pythonswirls/Supercluster2/README.md

https://m.youtube.com/watch?v=HRfbQJ6FdF0
