pythonswirls/Supercluster2/ClusterRaymarcher/readme.MD

## BUS

Client perspective:

A1: LED

A2:  CMD 

C0-7: DATA (open drain)

D0: CLK (open drain)

D2..D3: Packet Type (0: reset, 1:RECEIVE, 2:TRANSMIT, 3:BROADCAST) (open drain)

D4: ACK

D5: FULL

D6: EOT
