pythonswirls/Supercluster2/pcb/ClusterProgammer/clusterProgrammer.kicad_pcb

## KiCad design pcb/ClusterProgammer/clusterProgrammer.kicad_pcb (2025-07-05)

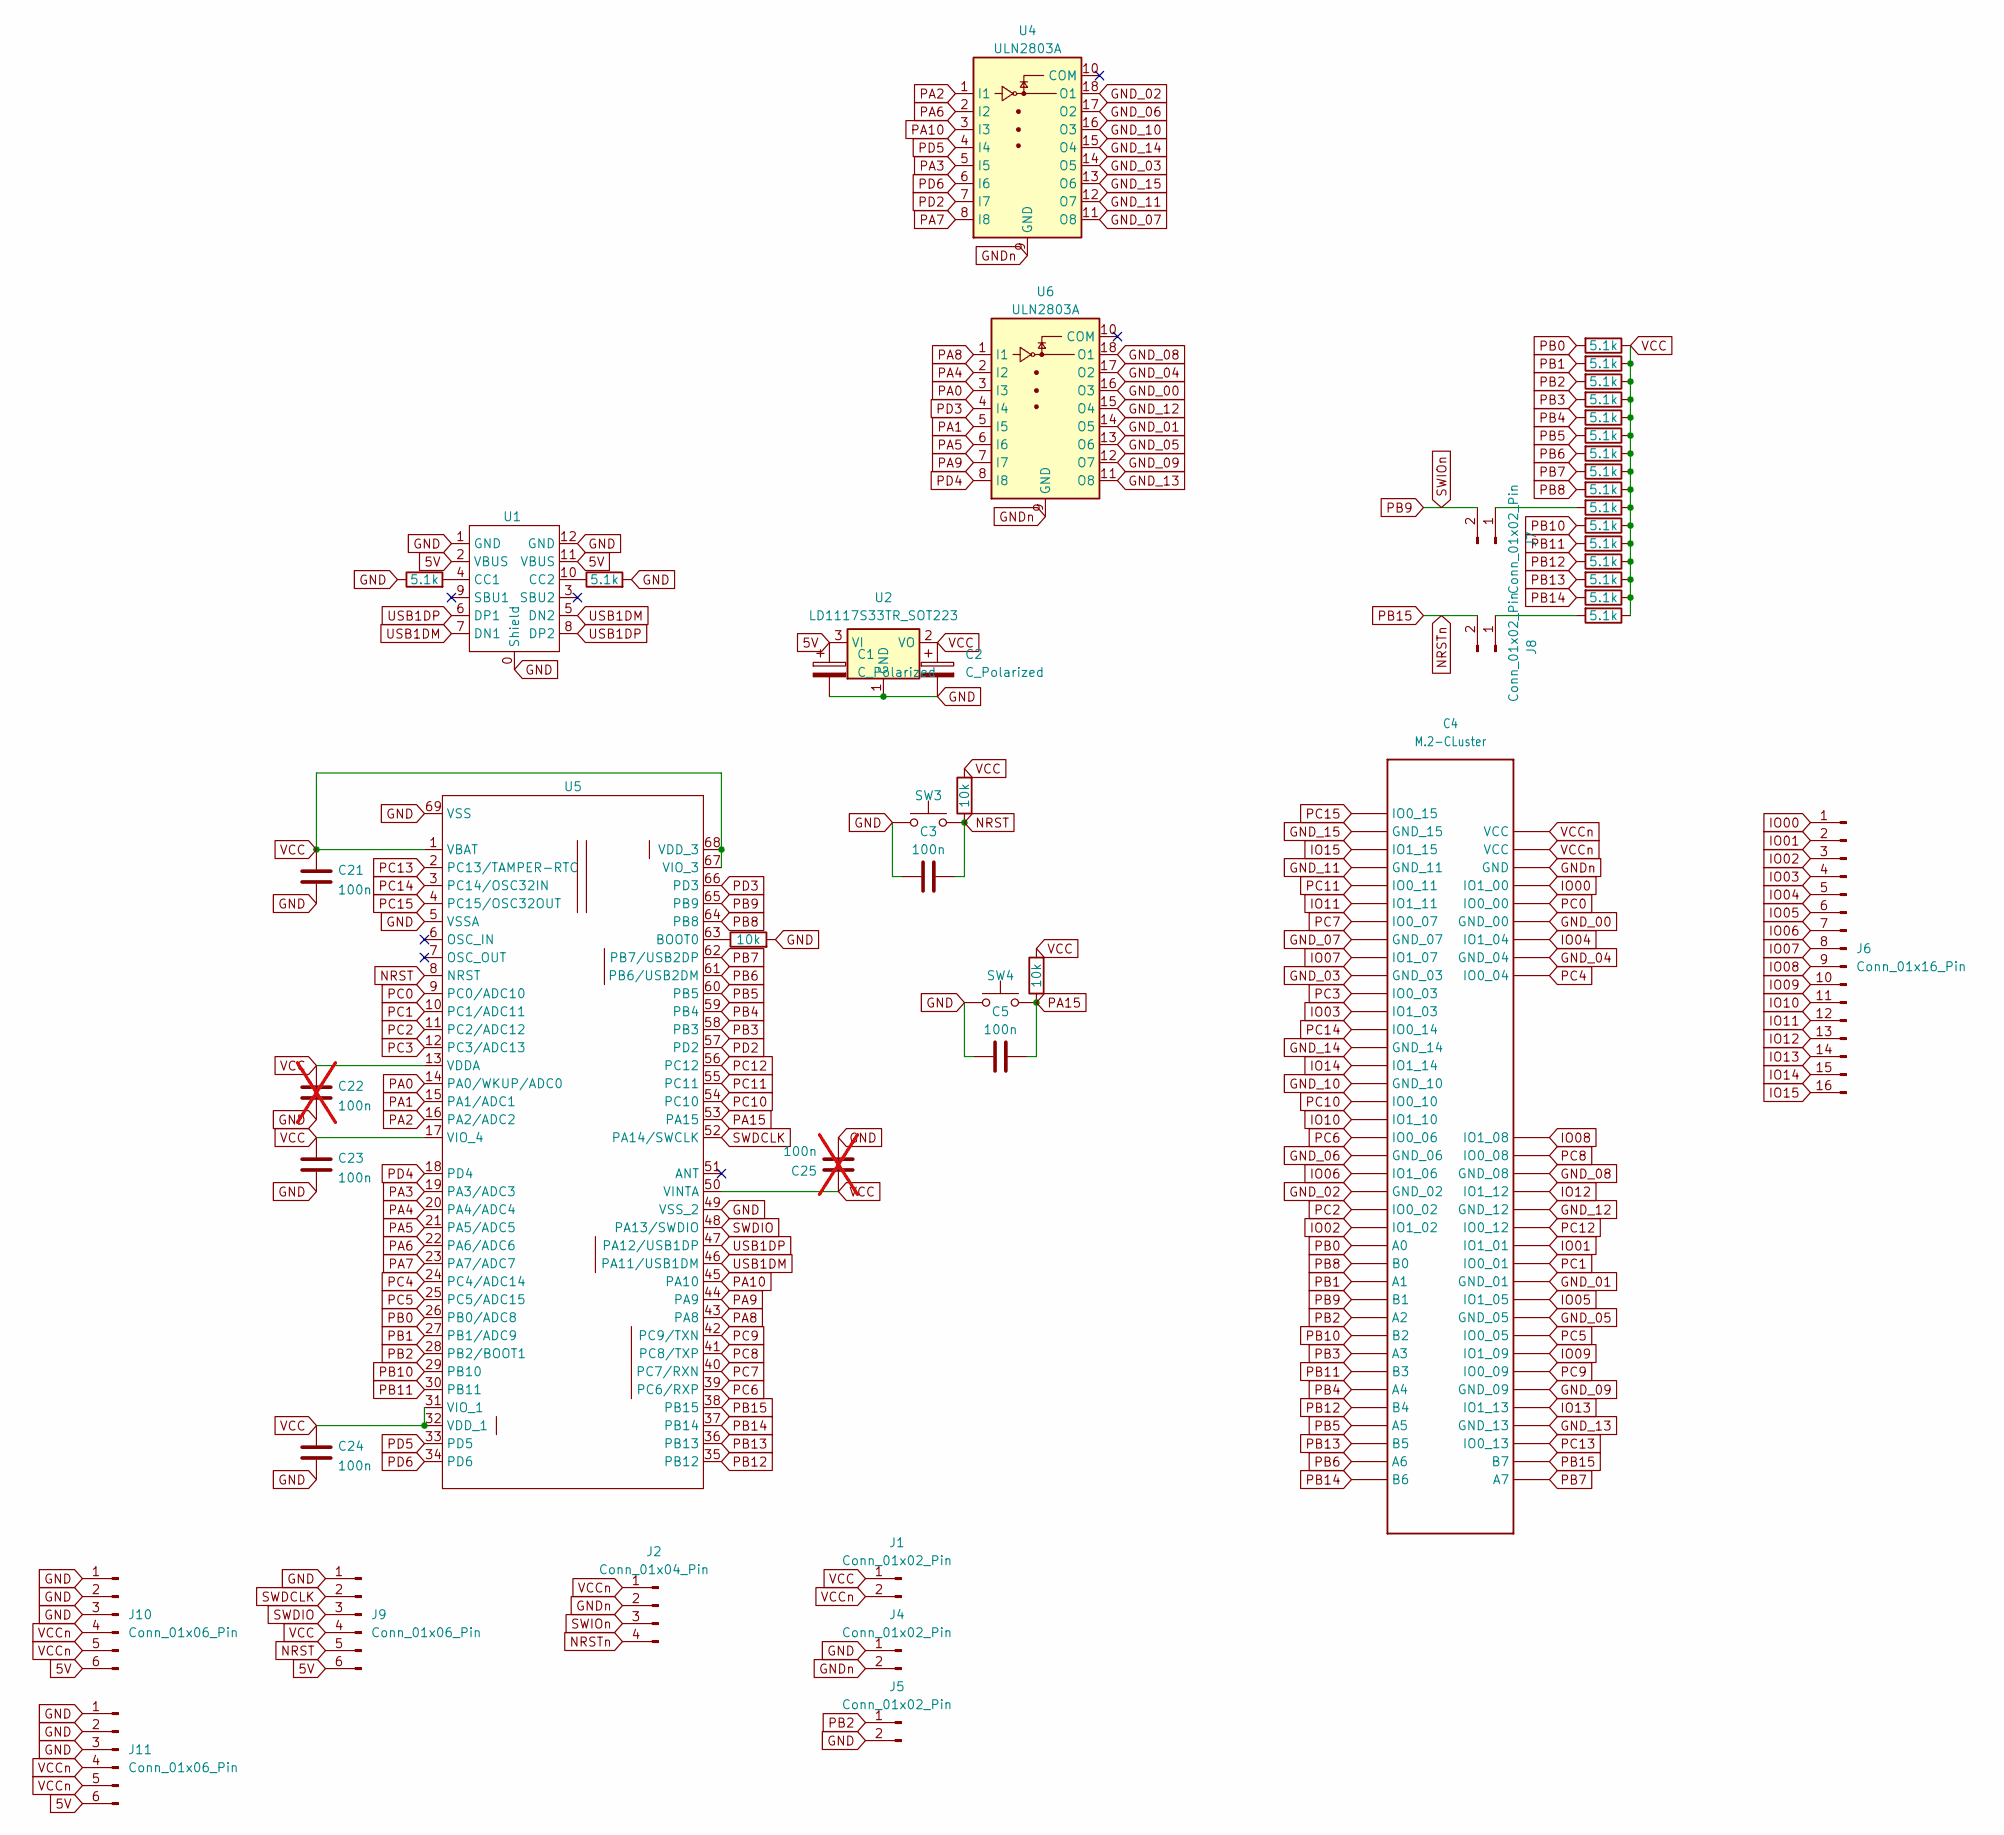
[picture p1: schematic clusterProgrammer.kicad_sch]

Parts:
C1, C2: C_Polarized; CP_Elec_4x4.5
C3, C5, C21, C23, C24: 100n; C_0603_1608Metric
C4: M.2-CLuster; M.2-Vertical
C22, C25: 100n; C_0603_1608Metric; not fitted
J1, J4, J5, J7, J8: Conn_01x02_Pin; PinHeader_1x02_P2.54mm_Vertical
J2: Conn_01x04_Pin; PinHeader_1x04_P2.54mm_Vertical
J6: Conn_01x16_Pin; PinSocket_1x16_P2.54mm_Vertical
J9, J10, J11: Conn_01x06_Pin; PinHeader_1x06_P2.54mm_Vertical
R1, R3, R4, R5, R6, R7, R8, R9, R10, R11, R12, R13, R14, R15, R16, R17, R18, R23: 5.1k; R_0603_1608Metric; LCSC C25905
R20, R21, R22: 10k; R_0603_1608Metric; LCSC C25905
SW3, SW4: miniButton; ButtonSMD5.2x5.2; LCSC C3020033
U1: USB-C; LCSC C165948
U2: LD1117S33TR_SOT223; SOT-223-3_TabPin2
U4, U6: ULN2803A; SOIC-18W_7.5x11.6mm_P1.27mm; LCSC C2828557
U5: QFN-68-1EP_8x8mm_P0.4mm_EP4x4mm; LCSC C5187528

Connections:
5V: C1.1, J9.6, J10.6, J11.6, U1.2 (VBUS), U1.11 (VBUS), U2.3 (VI)
GND: C1.2, C2.2, C3.2, C5.2, C21.2, C22.2, C23.2, C24.2, C25.2, J4.1, J5.2, J9.1, J10.1, J10.2, J10.3, J11.1, J11.2, J11.3, R1.1, R3.2, R20.2, SW3.1, SW4.1, U1.0 (Shield), U1.1 (GND), U1.12 (GND), U2.1 (GND), U5.5 (VSSA), U5.49 (VSS_2), U5.69 (VSS)
GND_00: C4.70 (GND_00), U6.16 (O3)
GND_01: C4.50 (GND_01), U6.14 (O5)
GND_02: C4.22 (GND_02), U4.18 (O1)
GND_03: C4.10 (GND_03), U4.14 (O5)
GND_04: C4.68 (GND_04), U6.17 (O2)
GND_05: C4.48 (GND_05), U6.13 (O6)
GND_06: C4.20 (GND_06), U4.17 (O2)
GND_07: C4.8 (GND_07), U4.11 (O8)
GND_08: C4.56 (GND_08), U6.18 (O1)
GND_09: C4.44 (GND_09), U6.12 (O7)
GND_10: C4.16 (GND_10), U4.16 (O3)
GND_11: C4.4 (GND_11), U4.12 (O7)
GND_12: C4.54 (GND_12), U6.15 (O4)
GND_13: C4.42 (GND_13), U6.11 (O8)
GND_14: C4.14 (GND_14), U4.15 (O4)
GND_15: C4.2 (GND_15), U4.13 (O6)
GNDn: C4.73 (GND), J2.2, J4.2, U4.9 (GND), U6.9 (GND)
IO00: C4.72 (IO1_00), J6.1
IO01: C4.52 (IO1_01), J6.2
IO02: C4.24 (IO1_02), J6.3
IO03: C4.12 (IO1_03), J6.4
IO04: C4.69 (IO1_04), J6.5
IO05: C4.49 (IO1_05), J6.6
IO06: C4.21 (IO1_06), J6.7
IO07: C4.9 (IO1_07), J6.8
IO08: C4.58 (IO1_08), J6.9
IO09: C4.46 (IO1_09), J6.10
IO10: C4.18 (IO1_10), J6.11
IO11: C4.6 (IO1_11), J6.12
IO12: C4.55 (IO1_12), J6.13
IO13: C4.43 (IO1_13), J6.14
IO14: C4.15 (IO1_14), J6.15
IO15: C4.3 (IO1_15), J6.16
NRST: C3.1, J9.5, R21.1, SW3.2, U5.8 (NRST)
NRSTn: C4.40 (B7), J2.4, J8.2, U5.38 (PB15)
unnamed: J7.1, R13.2
unnamed: J8.1, R23.2
unnamed: R1.2, U1.4 (CC1)
unnamed: R3.1, U1.10 (CC2)
unnamed: R20.1, U5.63 (BOOT0)
PA0: U5.14 (PA0/WKUP/ADC0), U6.3 (I3)
PA1: U5.15 (PA1/ADC1), U6.5 (I5)
PA2: U4.1 (I1), U5.16 (PA2/ADC2)
PA3: U4.5 (I5), U5.19 (PA3/ADC3)
PA4: U5.20 (PA4/ADC4), U6.2 (I2)
PA5: U5.21 (PA5/ADC5), U6.6 (I6)
PA6: U4.2 (I2), U5.22 (PA6/ADC6)
PA7: U4.8 (I8), U5.23 (PA7/ADC7)
PA8: U5.43 (PA8), U6.1 (I1)
PA9: U5.44 (PA9), U6.7 (I7)
PA10: U4.3 (I3), U5.45 (PA10)
PA15: C5.1, R22.1, SW4.2, U5.53 (PA15)
PB0: C4.25 (A0), R7.2, U5.26 (PB0/ADC8)
PB1: C4.27 (A1), R6.2, U5.27 (PB1/ADC9)
PB2: C4.29 (A2), J5.1, R5.2, U5.28 (PB2/BOOT1)
PB3: C4.31 (A3), R4.2, U5.58 (PB3)
PB4: C4.33 (A4), R8.2, U5.59 (PB4)
PB5: C4.35 (A5), R9.2, U5.60 (PB5)
PB6: C4.37 (A6), R10.2, U5.61 (PB6/USB2DM)
PB7: C4.39 (A7), R11.2, U5.62 (PB7/USB2DP)
PB8: C4.26 (B0), R12.2, U5.64 (PB8)
PB9: C4.28 (B1), J2.3, J7.2, U5.65 (PB9)
PB10: C4.30 (B2), R14.2, U5.29 (PB10)
PB11: C4.32 (B3), R15.2, U5.30 (PB11)
PB12: C4.34 (B4), R16.2, U5.35 (PB12)
PB13: C4.36 (B5), R17.2, U5.36 (PB13)
PB14: C4.38 (B6), R18.2, U5.37 (PB14)
PC0: C4.71 (IO0_00), U5.9 (PC0/ADC10)
PC1: C4.51 (IO0_01), U5.10 (PC1/ADC11)
PC2: C4.23 (IO0_02), U5.11 (PC2/ADC12)
PC3: C4.11 (IO0_03), U5.12 (PC3/ADC13)
PC4: C4.67 (IO0_04), U5.24 (PC4/ADC14)
PC5: C4.47 (IO0_05), U5.25 (PC5/ADC15)
PC6: C4.19 (IO0_06), U5.39 (PC6/RXP)
PC7: C4.7 (IO0_07), U5.40 (PC7/RXN)
PC8: C4.57 (IO0_08), U5.41 (PC8/TXP)
PC9: C4.45 (IO0_09), U5.42 (PC9/TXN)
PC10: C4.17 (IO0_10), U5.54 (PC10)
PC11: C4.5 (IO0_11), U5.55 (PC11)
PC12: C4.53 (IO0_12), U5.56 (PC12)
PC13: C4.41 (IO0_13), U5.2 (PC13/TAMPER-RTC)
PC14: C4.13 (IO0_14), U5.3 (PC14/OSC32IN)
PC15: C4.1 (IO0_15), U5.4 (PC15/OSC32OUT)
PD2: U4.7 (I7), U5.57 (PD2)
PD3: U5.66 (PD3), U6.4 (I4)
PD4: U5.18 (PD4), U6.8 (I8)
PD5: U4.4 (I4), U5.33 (PD5)
PD6: U4.6 (I6), U5.34 (PD6)
SWDCLK: J9.2, U5.52 (PA14/SWCLK)
SWDIO: J9.3, U5.48 (PA13/SWDIO)
USB1DM: U1.5 (DN2), U1.7 (DN1), U5.46 (PA11/USB1DM)
USB1DP: U1.6 (DP1), U1.8 (DP2), U5.47 (PA12/USB1DP)
VCC: C2.1, C21.1, C22.1, C23.1, C24.1, C25.1, J1.1, J9.4, R4.1, R5.1, R6.1, R7.1, R8.1, R9.1, R10.1, R11.1, R12.1, R13.1, R14.1, R15.1, R16.1, R17.1, R18.1, R21.2, R22.2, R23.1, U2.2 (VO), U5.1 (VBAT), U5.13 (VDDA), U5.17 (VIO_4), U5.31 (VIO_1), U5.32 (VDD_1), U5.50 (VINTA), U5.67 (VIO_3), U5.68 (VDD_3)
VCCn: C4.74 (VCC), C4.75 (VCC), J1.2, J2.1, J10.4, J10.5, J11.4, J11.5

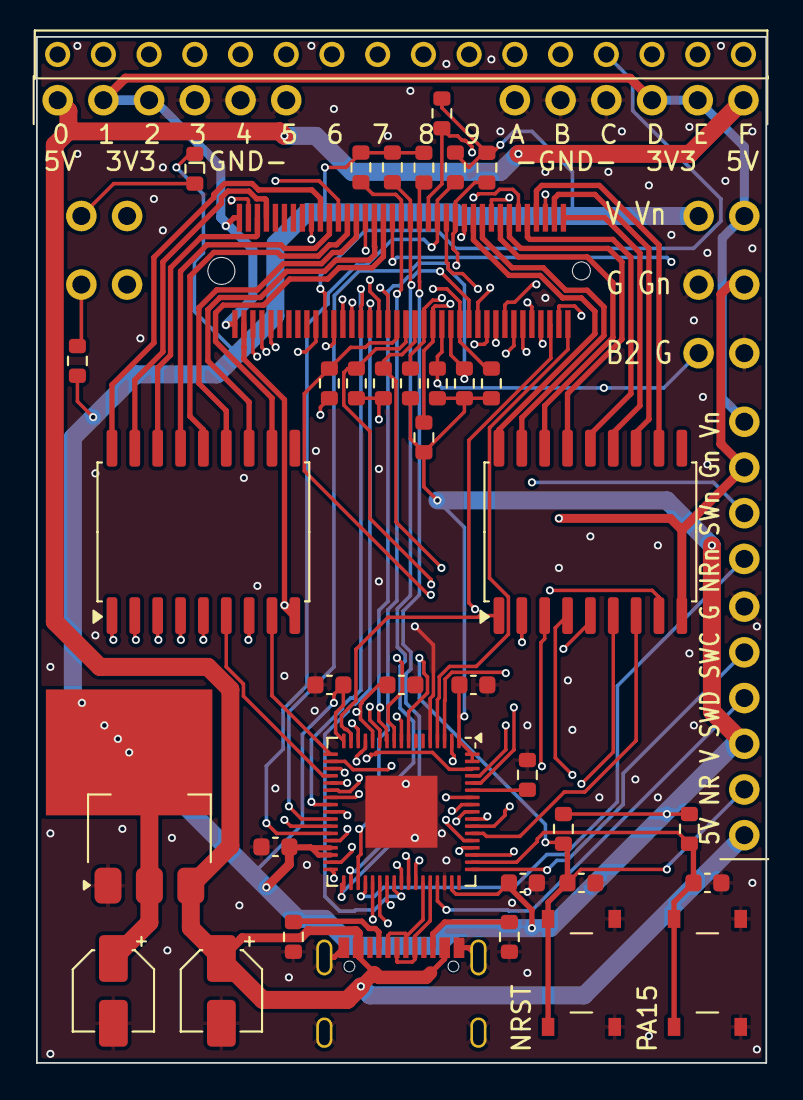
[picture p2: board clusterProgrammer.kicad_pcb from above]

Board: 4 copper layers, 40.5 x 57.0 mm, 48 parts (0 on the bottom side), 96 nets.
