pythonswirls/Supercluster2/pcb/ClusterBase/clusterbase.kicad_pcb

## KiCad design pcb/ClusterBase/clusterbase.kicad_pcb (2025-07-05)

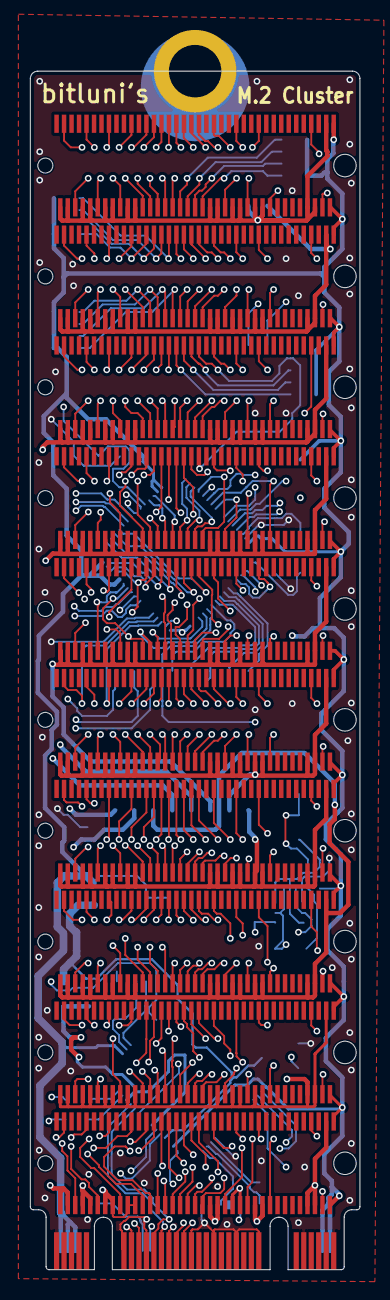
[picture p3: board clusterbase.kicad_pcb from above]

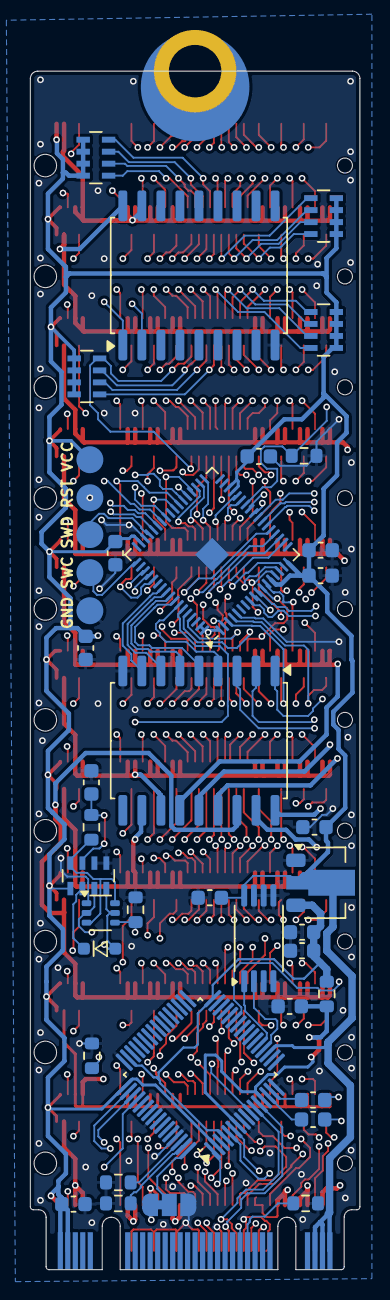
[picture p4: board clusterbase.kicad_pcb from below]

Board: 4 copper layers, 22.0 x 80.0 mm, 48 parts (37 on the bottom side), 82 nets.

Parts:
C1, C2, C3, C10, C12, C15, C26, C27, C28, C29, C30, C31: 100n; C_0603_1608Metric
C5, C6, C7, C9, C13, C14, C18, C19, C20, C21: M.2-CLuster; M.2-Vertical-short Pads
C8, C11: 10u; C_0603_1608Metric
D1: D; D_SOD-323
JP2: Jumper_3_Bridged12; SolderJumper-3_P1.3mm_Bridged12_RoundedPad1.0x1.5mm
Q1: UMH3N; SOT-363_SC-70-6
R9, R10, R11: 0; R_0603_1608Metric
R12: 12k; R_0603_1608Metric
R15, R16: 100k; R_0603_1608Metric
R18, R19: 10k; R_0603_1608Metric
RN6, RN7, RN8, RN9: 1k; R_Array_Concave_4x0603
RN10: 10k; R_Array_Concave_4x0603
TP2: TestPoint; Testpoint5
U1: CH382; LQFP-64_7x7mm_P0.4mm
U2: M.2-B+M-KEY-PCIe; M.2-B+M-KEY 2280
U3: MCP1703Ax-180xxMB; SOT-89-3
U4: M24C02-FDW; TSSOP-8_4.4x3mm_P0.65mm
U5, U7: ULN2803A; SOIC-18W_7.5x11.6mm_P1.27mm
U6: QFN-68-1EP_8x8mm_P0.4mm_EP1x1mm

Connections:
1V8: C10.2, C11.2, R9.1, U1.4 (VCC18), U1.32 (VCC18), U1.47 (VCC18), U3.3 (VO)
1V8A: C12.2, R9.2, U1.7 (VCC18A), U1.13 (VCC18A)
/CKSEL: JP2.2 (C), U1.64 (CKSEL)
/CLKREQ#: R18.2, U2.P$52 (CLKREQ#)
/DTR: Q1.2 (B1), RN10.3 (R3.1), U1.52 (DTR0)
/PECK+: U1.5 (PECK+), U2.P$55 (REFCLK+)
/PECK-: U1.6 (PECK-), U2.P$53 (REFCLK-)
/PER+: U1.11 (PER+), U2.P$49 (PER0+)
/PER-: U1.12 (PER-), U2.P$47 (PER0-)
/PET+: C2.2, U1.15 (PET+)
/PET-: C1.2, U1.14 (PET-)
/RST#: JP2.1 (A), U1.1 (PERST#), U2.P$50 (PERST#)
/RST_CH32#: C26.1, R16.2, RN10.7 (R2.2), TP2.4, U6.8 (NRST)
/RTS: D1.2 (A), Q1.5 (B2), RN10.4 (R4.1), U1.51 (RTS0)
/RX: U1.27 (RXD0), U6.44 (PA9)
/TX: U1.50 (TXD0), U6.45 (PA10)
BOOT0: Q1.4 (E2), R15.1, U6.63 (BOOT0)
GND: C3.1, C8.1, C10.1, C11.1, C12.1, C15.1, C26.2, C27.2, C28.2, C29.2, C30.2, C31.2, JP2.3 (B), Q1.1 (E1), R10.2, R11.2, R12.2, R15.2, R18.1, R19.2, RN10.5 (R4.2), RN10.6 (R3.2), TP2.1, U1.3 (GND), U1.8 (GND), U1.9 (GND), U1.16 (GND), U1.33 (GND), U1.48 (GND), U1.56 (GND), U1.61 (GND), U2.P$1 (CONFIG3/GND), U2.P$3 (GND), U2.P$9 (GND), U2.P$21 (CONFIG_0/GND), U2.P$27 (GND), U2.P$33 (GND), U2.P$39 (GND), U2.P$45 (GND), U2.P$51 (GND), U2.P$57 (GND), U2.P$71 (GND), U2.P$73 (GND), U2.P$75 (CONFIG_2/GND), U3.1 (GND), U4.3 (E2), U4.4 (VSS), U4.5 (SDA), U4.6 (SCL), U4.7 (~WC), U5.9 (GND), U6.5 (VSSA), U6.49 (VSS_2), U6.69 (VSS), U7.9 (GND)
GND00: C5.2 (GND_15), C5.4 (GND_11), C5.8 (GND_07), C5.10 (GND_03), C5.14 (GND_14), C5.16 (GND_10), C5.20 (GND_06), C5.22 (GND_02), C5.42 (GND_13), C5.44 (GND_09), C5.48 (GND_05), C5.50 (GND_01), C5.54 (GND_12), C5.56 (GND_08), C5.68 (GND_04), C5.70 (GND_00), C5.73 (GND), U5.17 (O2)
GND01: C6.2 (GND_15), C6.4 (GND_11), C6.8 (GND_07), C6.10 (GND_03), C6.14 (GND_14), C6.16 (GND_10), C6.20 (GND_06), C6.22 (GND_02), C6.42 (GND_13), C6.44 (GND_09), C6.48 (GND_05), C6.50 (GND_01), C6.54 (GND_12), C6.56 (GND_08), C6.68 (GND_04), C6.70 (GND_00), C6.73 (GND), U5.18 (O1)
GND02: C7.2 (GND_15), C7.4 (GND_11), C7.8 (GND_07), C7.10 (GND_03), C7.14 (GND_14), C7.16 (GND_10), C7.20 (GND_06), C7.22 (GND_02), C7.42 (GND_13), C7.44 (GND_09), C7.48 (GND_05), C7.50 (GND_01), C7.54 (GND_12), C7.56 (GND_08), C7.68 (GND_04), C7.70 (GND_00), C7.73 (GND), U5.16 (O3)
GND03: C9.2 (GND_15), C9.4 (GND_11), C9.8 (GND_07), C9.10 (GND_03), C9.14 (GND_14), C9.16 (GND_10), C9.20 (GND_06), C9.22 (GND_02), C9.42 (GND_13), C9.44 (GND_09), C9.48 (GND_05), C9.50 (GND_01), C9.54 (GND_12), C9.56 (GND_08), C9.68 (GND_04), C9.70 (GND_00), C9.73 (GND), U5.11 (O8)
GND04: C13.2 (GND_15), C13.4 (GND_11), C13.8 (GND_07), C13.10 (GND_03), C13.14 (GND_14), C13.16 (GND_10), C13.20 (GND_06), C13.22 (GND_02), C13.42 (GND_13), C13.44 (GND_09), C13.48 (GND_05), C13.50 (GND_01), C13.54 (GND_12), C13.56 (GND_08), C13.68 (GND_04), C13.70 (GND_00), C13.73 (GND), U5.12 (O7)
GND05: C14.2 (GND_15), C14.4 (GND_11), C14.8 (GND_07), C14.10 (GND_03), C14.14 (GND_14), C14.16 (GND_10), C14.20 (GND_06), C14.22 (GND_02), C14.42 (GND_13), C14.44 (GND_09), C14.48 (GND_05), C14.50 (GND_01), C14.54 (GND_12), C14.56 (GND_08), C14.68 (GND_04), C14.70 (GND_00), C14.73 (GND), U5.13 (O6)
GND06: C18.2 (GND_15), C18.4 (GND_11), C18.8 (GND_07), C18.10 (GND_03), C18.14 (GND_14), C18.16 (GND_10), C18.20 (GND_06), C18.22 (GND_02), C18.42 (GND_13), C18.44 (GND_09), C18.48 (GND_05), C18.50 (GND_01), C18.54 (GND_12), C18.56 (GND_08), C18.68 (GND_04), C18.70 (GND_00), C18.73 (GND), U5.14 (O5)
GND07: C19.2 (GND_15), C19.4 (GND_11), C19.8 (GND_07), C19.10 (GND_03), C19.14 (GND_14), C19.16 (GND_10), C19.20 (GND_06), C19.22 (GND_02), C19.42 (GND_13), C19.44 (GND_09), C19.48 (GND_05), C19.50 (GND_01), C19.54 (GND_12), C19.56 (GND_08), C19.68 (GND_04), C19.70 (GND_00), C19.73 (GND), U5.15 (O4)
GND08: C20.2 (GND_15), C20.4 (GND_11), C20.8 (GND_07), C20.10 (GND_03), C20.14 (GND_14), C20.16 (GND_10), C20.20 (GND_06), C20.22 (GND_02), C20.42 (GND_13), C20.44 (GND_09), C20.48 (GND_05), C20.50 (GND_01), C20.54 (GND_12), C20.56 (GND_08), C20.68 (GND_04), C20.70 (GND_00), C20.73 (GND), U7.18 (O1)
GND09: C21.2 (GND_15), C21.4 (GND_11), C21.8 (GND_07), C21.10 (GND_03), C21.14 (GND_14), C21.16 (GND_10), C21.20 (GND_06), C21.22 (GND_02), C21.42 (GND_13), C21.44 (GND_09), C21.48 (GND_05), C21.50 (GND_01), C21.54 (GND_12), C21.56 (GND_08), C21.68 (GND_04), C21.70 (GND_00), C21.73 (GND), U7.17 (O2)
unnamed: D1.1 (K), RN10.2 (R2.1)
unnamed: Q1.3 (C2), Q1.6 (C1), R16.1, RN10.8 (R1.2)
unnamed: R11.1, U1.62 (MDPRT#)
unnamed: R10.1, U1.63 (MDSEL)
unnamed: R12.1, U1.10 (RREF)
unnamed: U1.20 (SCL), U4.2 (E1)
unnamed: U1.21 (SDA), U4.1 (E0)
unnamed: C2.1, U2.P$43 (PET0+)
unnamed: C1.1, U2.P$41 (PET0-)
PA0: C5.25 (A0), C6.25 (A0), C7.25 (A0), C9.25 (A0), C13.25 (A0), C14.25 (A0), C18.25 (A0), C19.25 (A0), C20.25 (A0), C21.25 (A0), RN6.4 (R4.1), U6.14 (PA0/WKUP/ADC0)
PA1: C5.27 (A1), C6.27 (A1), C7.27 (A1), C9.27 (A1), C13.27 (A1), C14.27 (A1), C18.27 (A1), C19.27 (A1), C20.27 (A1), C21.27 (A1), RN6.3 (R3.1), U6.15 (PA1/ADC1)
PA2: C5.29 (A2), C6.29 (A2), C7.29 (A2), C9.29 (A2), C13.29 (A2), C14.29 (A2), C18.29 (A2), C19.29 (A2), C20.29 (A2), C21.29 (A2), RN6.2 (R2.1), U6.16 (PA2/ADC2)
PA3: C5.31 (A3), C6.31 (A3), C7.31 (A3), C9.31 (A3), C13.31 (A3), C14.31 (A3), C18.31 (A3), C19.31 (A3), C20.31 (A3), C21.31 (A3), RN6.1 (R1.1), U6.19 (PA3/ADC3)
PA4: C5.33 (A4), C6.33 (A4), C7.33 (A4), C9.33 (A4), C13.33 (A4), C14.33 (A4), C18.33 (A4), C19.33 (A4), C20.33 (A4), C21.33 (A4), RN7.1 (R1.1), U6.20 (PA4/ADC4)
PA5: C5.35 (A5), C6.35 (A5), C7.35 (A5), C9.35 (A5), C13.35 (A5), C14.35 (A5), C18.35 (A5), C19.35 (A5), C20.35 (A5), C21.35 (A5), RN7.2 (R2.1), U6.21 (PA5/ADC5)
PA6: C5.37 (A6), C6.37 (A6), C7.37 (A6), C9.37 (A6), C13.37 (A6), C14.37 (A6), C18.37 (A6), C19.37 (A6), C20.37 (A6), C21.37 (A6), RN7.3 (R3.1), U6.22 (PA6/ADC6)
PA7: C5.39 (A7), C6.39 (A7), C7.39 (A7), C9.39 (A7), C13.39 (A7), C14.39 (A7), C18.39 (A7), C19.39 (A7), C20.39 (A7), C21.39 (A7), RN7.4 (R4.1), U6.23 (PA7/ADC7)
PA11: U6.46 (PA11/USB1DM), U7.1 (I1)
PA12: U6.47 (PA12/USB1DP), U7.2 (I2)
PA13: TP2.3, U6.48 (PA13/SWDIO)
PA14: TP2.2, U6.52 (PA14/SWCLK)
PB0: U5.2 (I2), U6.26 (PB0/ADC8)
PB1: U5.1 (I1), U6.27 (PB1/ADC9)
PB2: R19.1, U5.3 (I3), U6.28 (PB2/BOOT1)
PB3: U5.8 (I8), U6.58 (PB3)
PB4: U5.7 (I7), U6.59 (PB4)
PB5: U5.6 (I6), U6.60 (PB5)
PB6: U5.5 (I5), U6.61 (PB6/USB2DM)
PB7: U5.4 (I4), U6.62 (PB7/USB2DP)
PB8: C5.26 (B0), C6.26 (B0), C7.26 (B0), C9.26 (B0), C13.26 (B0), C14.26 (B0), C18.26 (B0), C19.26 (B0), C20.26 (B0), C21.26 (B0), RN8.1 (R1.1), U6.64 (PB8)
PB9: C5.28 (B1), C6.28 (B1), C7.28 (B1), C9.28 (B1), C13.28 (B1), C14.28 (B1), C18.28 (B1), C19.28 (B1), C20.28 (B1), C21.28 (B1), RN8.2 (R2.1), U6.65 (PB9)
PB10: C5.30 (B2), C6.30 (B2), C7.30 (B2), C9.30 (B2), C13.30 (B2), C14.30 (B2), C18.30 (B2), C19.30 (B2), C20.30 (B2), C21.30 (B2), RN8.3 (R3.1), U6.29 (PB10)
PB11: C5.32 (B3), C6.32 (B3), C7.32 (B3), C9.32 (B3), C13.32 (B3), C14.32 (B3), C18.32 (B3), C19.32 (B3), C20.32 (B3), C21.32 (B3), RN8.4 (R4.1), U6.30 (PB11)
PB12: C5.34 (B4), C6.34 (B4), C7.34 (B4), C9.34 (B4), C13.34 (B4), C14.34 (B4), C18.34 (B4), C19.34 (B4), C20.34 (B4), C21.34 (B4), RN9.4 (R4.1), U6.35 (PB12)
PB13: C5.36 (B5), C6.36 (B5), C7.36 (B5), C9.36 (B5), C13.36 (B5), C14.36 (B5), C18.36 (B5), C19.36 (B5), C20.36 (B5), C21.36 (B5), RN9.3 (R3.1), U6.36 (PB13)
PB14: C5.38 (B6), C6.38 (B6), C7.38 (B6), C9.38 (B6), C13.38 (B6), C14.38 (B6), C18.38 (B6), C19.38 (B6), C20.38 (B6), C21.38 (B6), RN9.2 (R2.1), U6.37 (PB14)
PB15: C5.40 (B7), C6.40 (B7), C7.40 (B7), C9.40 (B7), C13.40 (B7), C14.40 (B7), C18.40 (B7), C19.40 (B7), C20.40 (B7), C21.40 (B7), RN9.1 (R1.1), U6.38 (PB15)
PC0: C5.72 (IO1_00), C6.72 (IO1_00), C7.72 (IO1_00), C9.72 (IO1_00), C13.72 (IO1_00), C14.72 (IO1_00), C18.72 (IO1_00), C19.72 (IO1_00), C20.72 (IO1_00), C21.72 (IO1_00), U6.9 (PC0/ADC10)
PC1: C5.52 (IO1_01), C6.52 (IO1_01), C7.52 (IO1_01), C9.52 (IO1_01), C13.52 (IO1_01), C14.52 (IO1_01), C18.52 (IO1_01), C19.52 (IO1_01), C20.52 (IO1_01), C21.52 (IO1_01), U6.10 (PC1/ADC11)
PC2: C5.24 (IO1_02), C6.24 (IO1_02), C7.24 (IO1_02), C9.24 (IO1_02), C13.24 (IO1_02), C14.24 (IO1_02), C18.24 (IO1_02), C19.24 (IO1_02), C20.24 (IO1_02), C21.24 (IO1_02), U6.11 (PC2/ADC12)
PC3: C5.12 (IO1_03), C6.12 (IO1_03), C7.12 (IO1_03), C9.12 (IO1_03), C13.12 (IO1_03), C14.12 (IO1_03), C18.12 (IO1_03), C19.12 (IO1_03), C20.12 (IO1_03), C21.12 (IO1_03), U6.12 (PC3/ADC13)
PC4: C5.69 (IO1_04), C6.69 (IO1_04), C7.69 (IO1_04), C9.69 (IO1_04), C13.69 (IO1_04), C14.69 (IO1_04), C18.69 (IO1_04), C19.69 (IO1_04), C20.69 (IO1_04), C21.69 (IO1_04), U6.24 (PC4/ADC14)
PC5: C5.49 (IO1_05), C6.49 (IO1_05), C7.49 (IO1_05), C9.49 (IO1_05), C13.49 (IO1_05), C14.49 (IO1_05), C18.49 (IO1_05), C19.49 (IO1_05), C20.49 (IO1_05), C21.49 (IO1_05), U6.25 (PC5/ADC15)
PC6: C5.21 (IO1_06), C6.21 (IO1_06), C7.21 (IO1_06), C9.21 (IO1_06), C13.21 (IO1_06), C14.21 (IO1_06), C18.21 (IO1_06), C19.21 (IO1_06), C20.21 (IO1_06), C21.21 (IO1_06), U6.39 (PC6/RXP)
PC7: C5.9 (IO1_07), C6.9 (IO1_07), C7.9 (IO1_07), C9.9 (IO1_07), C13.9 (IO1_07), C14.9 (IO1_07), C18.9 (IO1_07), C19.9 (IO1_07), C20.9 (IO1_07), C21.9 (IO1_07), U6.40 (PC7/RXN)
PC8: C5.58 (IO1_08), C6.58 (IO1_08), C7.58 (IO1_08), C9.58 (IO1_08), C13.58 (IO1_08), C14.58 (IO1_08), C18.58 (IO1_08), C19.58 (IO1_08), C20.58 (IO1_08), C21.58 (IO1_08), U6.41 (PC8/TXP)
PC9: C5.46 (IO1_09), C6.46 (IO1_09), C7.46 (IO1_09), C9.46 (IO1_09), C13.46 (IO1_09), C14.46 (IO1_09), C18.46 (IO1_09), C19.46 (IO1_09), C20.46 (IO1_09), C21.46 (IO1_09), U6.42 (PC9/TXN)
PC10: C5.18 (IO1_10), C6.18 (IO1_10), C7.18 (IO1_10), C9.18 (IO1_10), C13.18 (IO1_10), C14.18 (IO1_10), C18.18 (IO1_10), C19.18 (IO1_10), C20.18 (IO1_10), C21.18 (IO1_10), U6.54 (PC10)
PC11: C5.6 (IO1_11), C6.6 (IO1_11), C7.6 (IO1_11), C9.6 (IO1_11), C13.6 (IO1_11), C14.6 (IO1_11), C18.6 (IO1_11), C19.6 (IO1_11), C20.6 (IO1_11), C21.6 (IO1_11), U6.55 (PC11)
PC12: C5.55 (IO1_12), C6.55 (IO1_12), C7.55 (IO1_12), C9.55 (IO1_12), C13.55 (IO1_12), C14.55 (IO1_12), C18.55 (IO1_12), C19.55 (IO1_12), C20.55 (IO1_12), C21.55 (IO1_12), U6.56 (PC12)
PC13: C5.43 (IO1_13), C6.43 (IO1_13), C7.43 (IO1_13), C9.43 (IO1_13), C13.43 (IO1_13), C14.43 (IO1_13), C18.43 (IO1_13), C19.43 (IO1_13), C20.43 (IO1_13), C21.43 (IO1_13), U6.2 (PC13/TAMPER-RTC)
PC14: C5.15 (IO1_14), C6.15 (IO1_14), C7.15 (IO1_14), C9.15 (IO1_14), C13.15 (IO1_14), C14.15 (IO1_14), C18.15 (IO1_14), C19.15 (IO1_14), C20.15 (IO1_14), C21.15 (IO1_14), U6.3 (PC14/OSC32IN)
PC15: C5.3 (IO1_15), C6.3 (IO1_15), C7.3 (IO1_15), C9.3 (IO1_15), C13.3 (IO1_15), C14.3 (IO1_15), C18.3 (IO1_15), C19.3 (IO1_15), C20.3 (IO1_15), C21.3 (IO1_15), U6.4 (PC15/OSC32OUT)
VCC: C3.2, C5.74 (VCC), C5.75 (VCC), C6.74 (VCC), C6.75 (VCC), C7.74 (VCC), C7.75 (VCC), C8.2, C9.74 (VCC), C9.75 (VCC), C13.74 (VCC), C13.75 (VCC), C14.74 (VCC), C14.75 (VCC), C15.2, C18.74 (VCC), C18.75 (VCC), C19.74 (VCC), C19.75 (VCC), C20.74 (VCC), C20.75 (VCC), C21.74 (VCC), C21.75 (VCC), C27.1, C28.1, C29.1, C30.1, C31.1, RN6.5 (R4.2), RN6.6 (R3.2), RN6.7 (R2.2), RN6.8 (R1.2), RN7.5 (R4.2), RN7.6 (R3.2), RN7.7 (R2.2), RN7.8 (R1.2), RN8.5 (R4.2), RN8.6 (R3.2), RN8.7 (R2.2), RN8.8 (R1.2), RN9.5 (R4.2), RN9.6 (R3.2), RN9.7 (R2.2), RN9.8 (R1.2), RN10.1 (R1.1), TP2.5, U1.2 (VCC33), U1.19 (VCC33), U1.49 (VCC33), U2.P$2 (3V3), U2.P$4 (3V3), U2.P$70 (3V3), U2.P$72 (3V3), U2.P$74 (3V3), U3.2 (VI), U4.8 (VCC), U6.1 (VBAT), U6.13 (VDDA), U6.17 (VIO_4), U6.31 (VIO_1), U6.32 (VDD_1), U6.50 (VINTA), U6.67 (VIO_3), U6.68 (VDD_3)
