pythonswirls/Supercluster2/pcb/ClusterCard/clustercard.kicad_pcb

## KiCad design pcb/ClusterCard/clustercard.kicad_pcb (2025-07-05)

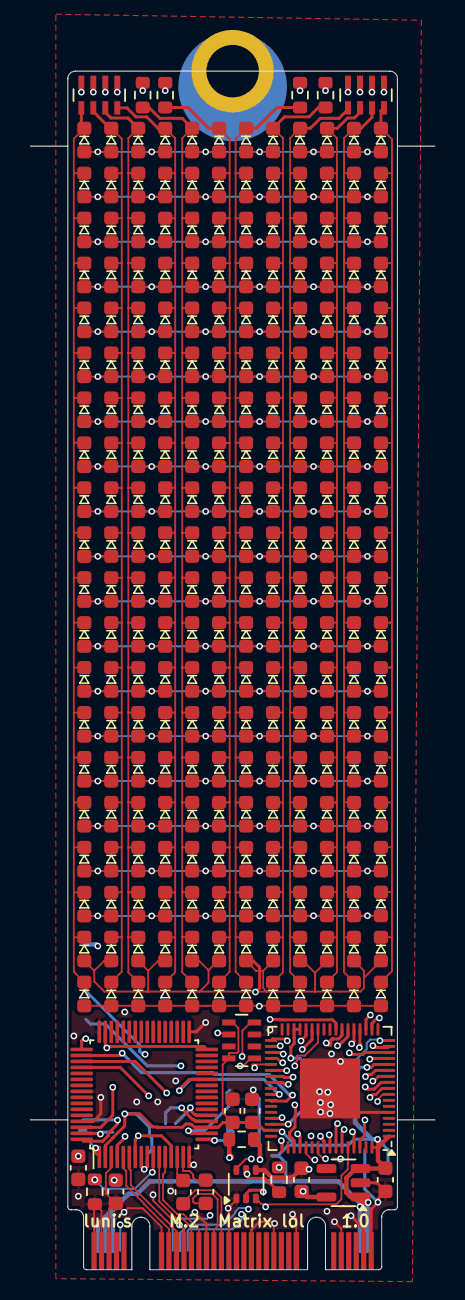
[picture p5: board clustercard.kicad_pcb from above]

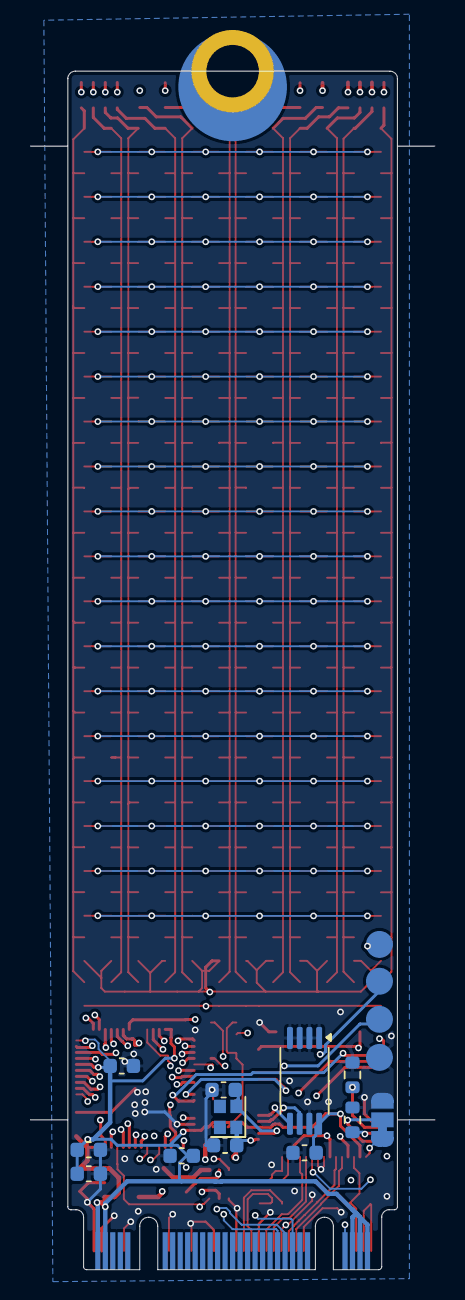
[picture p6: board clustercard.kicad_pcb from below]

Board: 4 copper layers, 22.0 x 80.0 mm, 276 parts (13 on the bottom side), 77 nets.

Parts:
C1, C2, C3, C10, C12, C15, C21, C22, C23, C24, C25: 100n; C_0603_1608Metric
C8, C11: 10u; C_0603_1608Metric
C16, C17: 27p; C_0603_1608Metric
D121, D122, D123, D124, D125, D126, D127, D128, D129, D130, D131, D132, D133, D134, D135, D136, D137, D138, D139, D140, D141, D142, D143, D144, D145, D146, D147, D148, D149, D150, D151, D152, D153, D154, D155, D156, D157, D158, D159, D160, D161, D162, D163, D164, D165, D166, D167, D168, D169, D170, D171, D172, D173, D174, D175, D176, D177, D178, D179, D180, D181, D182, D183, D184, D185, D186, D187, D188, D189, D190, D191, D192, D193, D194, D195, D196, D197, D198, D199, D200, D201, D202, D203, D204, D205, D206, D207, D208, D209, D210, D211, D212, D213, D214, D215, D216, D217, D218, D219, D220, D221, D222, D223, D224, D225, D226, D227, D228, D229, D230, D231, D232, D233, D234, D235, D236, D237, D238, D239, D240, D241, D242, D243, D244, D245, D246, D247, D248, D249, D250, D251, D252, D253, D254, D255, D256, D257, D258, D259, D260, D261, D262, D263, D264, D265, D266, D267, D268, D269, D270, D271, D272, D273, D274, D275, D276, D277, D278, D279, D280, D281, D282, D283, D284, D285, D286, D287, D288, D289, D290, D291, D292, D293, D294, D295, D296, D297, D298, D299, D300, D301, D302, D303, D304, D305, D306, D307, D308, D309, D310, D311, D312, D313, D314, D315, D316, D317, D318, D319, D320, D321, D322, D323, D324, D325, D326, D327, D328, D329, D330, D331, D332, D333, D334, D335, D336, D337, D338, D339, D340, D341, D342, D343, D344, D345, D346, D347, D348, D349, D350, D351, D352, D353, D354, D355, D356, D357, D358, D359, D360: LEDdiag0603; LED_0603
JP2: Jumper_3_Bridged12; SolderJumper-3_P1.3mm_Bridged12_RoundedPad1.0x1.5mm
Q1: UMH3N; SOT-363_SC-70-6
R8, R13, R14, R15, R16: 1k; R_0603_1608Metric
R9, R10, R11: 0; R_0603_1608Metric
R12: 12k; R_0603_1608Metric
RN5, RN6: 1k; R_Array_Concave_4x0603
RN8: 10k; R_Array_Concave_4x0603
TP1: TestPoint; Testpoint4
U1: CH382; LQFP-64_7x7mm_P0.4mm
U2: M.2-B+M-KEY-PCIe; M.2-B+M-KEY 2280
U4: M24C02-FDW; TSSOP-8_4.4x3mm_P0.65mm
U5: QFN-68-1EP_8x8mm_P0.4mm_EP4x4mm
U6: AP2112K-1.8; SOT-23-5
Y1: 22.1184MHz; Crystal_SMD_2016-4Pin_2.0x1.6mm

Connections:
1V8: C10.2, C11.2, R9.1, U1.4 (VCC18), U1.32 (VCC18), U1.47 (VCC18), U6.5 (VOUT)
1V8A: C12.2, R9.2, U1.7 (VCC18A), U1.13 (VCC18A)
/BOOT1: R8.2, U5.28 (PB2/BOOT1)
/CKSEL: JP2.2 (C), U1.64 (CKSEL)
/CLKREQ#: RN8.2 (R2.1), U2.P$52 (CLKREQ#)
/CLK_32k: U2.P$68 (SUSCLK(32kHz)), U5.58 (PB3)
/DTR: Q1.2 (B1), U1.52 (DTR0)
/PECK+: U1.5 (PECK+), U2.P$55 (REFCLK+)
/PECK-: U1.6 (PECK-), U2.P$53 (REFCLK-)
/PER+: U1.11 (PER+), U2.P$49 (PER0+)
/PER-: U1.12 (PER-), U2.P$47 (PER0-)
/PET+: C2.2, U1.15 (PET+)
/PET-: C1.2, U1.14 (PET-)
/RST#: JP2.1 (A), U1.1 (PERST#), U2.P$50 (PERST#)
/RST_CH32#: Q1.6 (C1), RN8.8 (R1.2), U5.8 (NRST)
/RTS: Q1.5 (B2), R8.1, U1.51 (RTS0)
/RX: U1.27 (RXD0), U5.44 (PA9)
/TX: U1.50 (TXD0), U5.45 (PA10)
/WAKE#: U2.P$54 (PEWAKE#), U5.56 (PC12)
BOOT0: Q1.3 (C2), RN8.5 (R4.2), U5.63 (BOOT0)
GND: C3.1, C8.1, C10.1, C11.1, C12.1, C15.1, C16.2, C17.2, C21.2, C22.2, C23.2, C24.2, C25.2, JP2.3 (B), Q1.1 (E1), Q1.4 (E2), R10.2, R11.2, R12.2, RN8.7 (R2.2), TP1.1, U1.3 (GND), U1.8 (GND), U1.9 (GND), U1.16 (GND), U1.33 (GND), U1.48 (GND), U1.56 (GND), U1.61 (GND), U2.P$1 (CONFIG3/GND), U2.P$3 (GND), U2.P$9 (GND), U2.P$21 (CONFIG_0/GND), U2.P$27 (GND), U2.P$33 (GND), U2.P$39 (GND), U2.P$45 (GND), U2.P$51 (GND), U2.P$57 (GND), U2.P$71 (GND), U2.P$73 (GND), U2.P$75 (CONFIG_2/GND), U4.1 (E0), U4.2 (E1), U4.3 (E2), U4.4 (VSS), U4.7 (~WC), U5.5 (VSSA), U5.49 (VSS_2), U5.69 (VSS), U6.2 (GND)
unnamed: D121.1 (K), D133.1 (K), D145.1 (K), D157.1 (K), D169.1 (K), D181.1 (K), D193.1 (K), D205.1 (K), D217.1 (K), D229.1 (K), D241.1 (K), D253.1 (K), D265.1 (K), D277.1 (K), D289.1 (K), D301.1 (K), D313.1 (K), D325.1 (K), D337.1 (K), D349.1 (K), RN5.4 (R4.1)
unnamed: D122.1 (K), D134.1 (K), D146.1 (K), D158.1 (K), D170.1 (K), D182.1 (K), D194.1 (K), D206.1 (K), D218.1 (K), D230.1 (K), D242.1 (K), D254.1 (K), D266.1 (K), D278.1 (K), D290.1 (K), D302.1 (K), D314.1 (K), D326.1 (K), D338.1 (K), D350.1 (K), RN5.3 (R3.1)
unnamed: D123.1 (K), D135.1 (K), D147.1 (K), D159.1 (K), D171.1 (K), D183.1 (K), D195.1 (K), D207.1 (K), D219.1 (K), D231.1 (K), D243.1 (K), D255.1 (K), D267.1 (K), D279.1 (K), D291.1 (K), D303.1 (K), D315.1 (K), D327.1 (K), D339.1 (K), D351.1 (K), RN5.2 (R2.1)
unnamed: D124.1 (K), D136.1 (K), D148.1 (K), D160.1 (K), D172.1 (K), D184.1 (K), D196.1 (K), D208.1 (K), D220.1 (K), D232.1 (K), D244.1 (K), D256.1 (K), D268.1 (K), D280.1 (K), D292.1 (K), D304.1 (K), D316.1 (K), D328.1 (K), D340.1 (K), D352.1 (K), RN5.1 (R1.1)
unnamed: D125.1 (K), D137.1 (K), D149.1 (K), D161.1 (K), D173.1 (K), D185.1 (K), D197.1 (K), D209.1 (K), D221.1 (K), D233.1 (K), D245.1 (K), D257.1 (K), D269.1 (K), D281.1 (K), D293.1 (K), D305.1 (K), D317.1 (K), D329.1 (K), D341.1 (K), D353.1 (K), R13.1
unnamed: D126.1 (K), D138.1 (K), D150.1 (K), D162.1 (K), D174.1 (K), D186.1 (K), D198.1 (K), D210.1 (K), D222.1 (K), D234.1 (K), D246.1 (K), D258.1 (K), D270.1 (K), D282.1 (K), D294.1 (K), D306.1 (K), D318.1 (K), D330.1 (K), D342.1 (K), D354.1 (K), R14.1
unnamed: D127.1 (K), D139.1 (K), D151.1 (K), D163.1 (K), D175.1 (K), D187.1 (K), D199.1 (K), D211.1 (K), D223.1 (K), D235.1 (K), D247.1 (K), D259.1 (K), D271.1 (K), D283.1 (K), D295.1 (K), D307.1 (K), D319.1 (K), D331.1 (K), D343.1 (K), D355.1 (K), R15.1
unnamed: D128.1 (K), D140.1 (K), D152.1 (K), D164.1 (K), D176.1 (K), D188.1 (K), D200.1 (K), D212.1 (K), D224.1 (K), D236.1 (K), D248.1 (K), D260.1 (K), D272.1 (K), D284.1 (K), D296.1 (K), D308.1 (K), D320.1 (K), D332.1 (K), D344.1 (K), D356.1 (K), R16.1
unnamed: D129.1 (K), D141.1 (K), D153.1 (K), D165.1 (K), D177.1 (K), D189.1 (K), D201.1 (K), D213.1 (K), D225.1 (K), D237.1 (K), D249.1 (K), D261.1 (K), D273.1 (K), D285.1 (K), D297.1 (K), D309.1 (K), D321.1 (K), D333.1 (K), D345.1 (K), D357.1 (K), RN6.4 (R4.1)
unnamed: D130.1 (K), D142.1 (K), D154.1 (K), D166.1 (K), D178.1 (K), D190.1 (K), D202.1 (K), D214.1 (K), D226.1 (K), D238.1 (K), D250.1 (K), D262.1 (K), D274.1 (K), D286.1 (K), D298.1 (K), D310.1 (K), D322.1 (K), D334.1 (K), D346.1 (K), D358.1 (K), RN6.3 (R3.1)
unnamed: D131.1 (K), D143.1 (K), D155.1 (K), D167.1 (K), D179.1 (K), D191.1 (K), D203.1 (K), D215.1 (K), D227.1 (K), D239.1 (K), D251.1 (K), D263.1 (K), D275.1 (K), D287.1 (K), D299.1 (K), D311.1 (K), D323.1 (K), D335.1 (K), D347.1 (K), D359.1 (K), RN6.2 (R2.1)
unnamed: D132.1 (K), D144.1 (K), D156.1 (K), D168.1 (K), D180.1 (K), D192.1 (K), D204.1 (K), D216.1 (K), D228.1 (K), D240.1 (K), D252.1 (K), D264.1 (K), D276.1 (K), D288.1 (K), D300.1 (K), D312.1 (K), D324.1 (K), D336.1 (K), D348.1 (K), D360.1 (K), RN6.1 (R1.1)
unnamed: R11.1, U1.62 (MDPRT#)
unnamed: R10.1, U1.63 (MDSEL)
unnamed: R12.1, U1.10 (RREF)
unnamed: U1.20 (SCL), U4.6 (SCL)
unnamed: U1.21 (SDA), U4.5 (SDA)
unnamed: C16.1, U1.18 (XI), Y1.2
unnamed: C17.1, U1.17 (XO), Y1.1
unnamed: C2.1, U2.P$43 (PET0+)
unnamed: C1.1, U2.P$41 (PET0-)
PA0: D121.2 (A), D122.2 (A), D123.2 (A), D124.2 (A), D125.2 (A), D126.2 (A), D127.2 (A), D128.2 (A), D129.2 (A), D130.2 (A), D131.2 (A), D132.2 (A), U5.14 (PA0/WKUP/ADC0)
PA1: D133.2 (A), D134.2 (A), D135.2 (A), D136.2 (A), D137.2 (A), D138.2 (A), D139.2 (A), D140.2 (A), D141.2 (A), D142.2 (A), D143.2 (A), D144.2 (A), U5.15 (PA1/ADC1)
PA2: D145.2 (A), D146.2 (A), D147.2 (A), D148.2 (A), D149.2 (A), D150.2 (A), D151.2 (A), D152.2 (A), D153.2 (A), D154.2 (A), D155.2 (A), D156.2 (A), U5.16 (PA2/ADC2)
PA3: D157.2 (A), D158.2 (A), D159.2 (A), D160.2 (A), D161.2 (A), D162.2 (A), D163.2 (A), D164.2 (A), D165.2 (A), D166.2 (A), D167.2 (A), D168.2 (A), U5.19 (PA3/ADC3)
PA4: D169.2 (A), D170.2 (A), D171.2 (A), D172.2 (A), D173.2 (A), D174.2 (A), D175.2 (A), D176.2 (A), D177.2 (A), D178.2 (A), D179.2 (A), D180.2 (A), U5.20 (PA4/ADC4)
PA5: D181.2 (A), D182.2 (A), D183.2 (A), D184.2 (A), D185.2 (A), D186.2 (A), D187.2 (A), D188.2 (A), D189.2 (A), D190.2 (A), D191.2 (A), D192.2 (A), U5.21 (PA5/ADC5)
PA6: D193.2 (A), D194.2 (A), D195.2 (A), D196.2 (A), D197.2 (A), D198.2 (A), D199.2 (A), D200.2 (A), D201.2 (A), D202.2 (A), D203.2 (A), D204.2 (A), U5.22 (PA6/ADC6)
PA7: D205.2 (A), D206.2 (A), D207.2 (A), D208.2 (A), D209.2 (A), D210.2 (A), D211.2 (A), D212.2 (A), D213.2 (A), D214.2 (A), D215.2 (A), D216.2 (A), U5.23 (PA7/ADC7)
PB4: D217.2 (A), D218.2 (A), D219.2 (A), D220.2 (A), D221.2 (A), D222.2 (A), D223.2 (A), D224.2 (A), D225.2 (A), D226.2 (A), D227.2 (A), D228.2 (A), U5.59 (PB4)
PB5: D229.2 (A), D230.2 (A), D231.2 (A), D232.2 (A), D233.2 (A), D234.2 (A), D235.2 (A), D236.2 (A), D237.2 (A), D238.2 (A), D239.2 (A), D240.2 (A), U5.60 (PB5)
PB6: D241.2 (A), D242.2 (A), D243.2 (A), D244.2 (A), D245.2 (A), D246.2 (A), D247.2 (A), D248.2 (A), D249.2 (A), D250.2 (A), D251.2 (A), D252.2 (A), U5.61 (PB6/USB2DM)
PB7: D253.2 (A), D254.2 (A), D255.2 (A), D256.2 (A), D257.2 (A), D258.2 (A), D259.2 (A), D260.2 (A), D261.2 (A), D262.2 (A), D263.2 (A), D264.2 (A), U5.62 (PB7/USB2DP)
PB8: D265.2 (A), D266.2 (A), D267.2 (A), D268.2 (A), D269.2 (A), D270.2 (A), D271.2 (A), D272.2 (A), D273.2 (A), D274.2 (A), D275.2 (A), D276.2 (A), U5.64 (PB8)
PB9: D277.2 (A), D278.2 (A), D279.2 (A), D280.2 (A), D281.2 (A), D282.2 (A), D283.2 (A), D284.2 (A), D285.2 (A), D286.2 (A), D287.2 (A), D288.2 (A), U5.65 (PB9)
PB10: D289.2 (A), D290.2 (A), D291.2 (A), D292.2 (A), D293.2 (A), D294.2 (A), D295.2 (A), D296.2 (A), D297.2 (A), D298.2 (A), D299.2 (A), D300.2 (A), U5.29 (PB10)
PB11: D301.2 (A), D302.2 (A), D303.2 (A), D304.2 (A), D305.2 (A), D306.2 (A), D307.2 (A), D308.2 (A), D309.2 (A), D310.2 (A), D311.2 (A), D312.2 (A), U5.30 (PB11)
PB12: D313.2 (A), D314.2 (A), D315.2 (A), D316.2 (A), D317.2 (A), D318.2 (A), D319.2 (A), D320.2 (A), D321.2 (A), D322.2 (A), D323.2 (A), D324.2 (A), U5.35 (PB12)
PB13: D325.2 (A), D326.2 (A), D327.2 (A), D328.2 (A), D329.2 (A), D330.2 (A), D331.2 (A), D332.2 (A), D333.2 (A), D334.2 (A), D335.2 (A), D336.2 (A), U5.36 (PB13)
PB14: D337.2 (A), D338.2 (A), D339.2 (A), D340.2 (A), D341.2 (A), D342.2 (A), D343.2 (A), D344.2 (A), D345.2 (A), D346.2 (A), D347.2 (A), D348.2 (A), U5.37 (PB14)
PB15: D349.2 (A), D350.2 (A), D351.2 (A), D352.2 (A), D353.2 (A), D354.2 (A), D355.2 (A), D356.2 (A), D357.2 (A), D358.2 (A), D359.2 (A), D360.2 (A), U5.38 (PB15)
PC0: RN5.5 (R4.2), U5.9 (PC0/ADC10)
PC1: RN5.6 (R3.2), U5.10 (PC1/ADC11)
PC2: RN5.7 (R2.2), U5.11 (PC2/ADC12)
PC3: RN5.8 (R1.2), U5.12 (PC3/ADC13)
PC4: R13.2, U5.24 (PC4/ADC14)
PC5: R14.2, U5.25 (PC5/ADC15)
PC6: R15.2, U5.39 (PC6/RXP)
PC7: R16.2, U5.40 (PC7/RXN)
PC8: RN6.5 (R4.2), U5.41 (PC8/TXP)
PC9: RN6.6 (R3.2), U5.42 (PC9/TXN)
PC10: RN6.7 (R2.2), U5.54 (PC10)
PC11: RN6.8 (R1.2), U5.55 (PC11)
SWDCLK: TP1.2, U5.52 (PA14/SWCLK)
SWDIO: TP1.3, U5.48 (PA13/SWDIO)
VCC: C3.2, C8.2, C15.2, C21.1, C22.1, C23.1, C24.1, C25.1, RN8.1 (R1.1), RN8.4 (R4.1), TP1.4, U1.2 (VCC33), U1.19 (VCC33), U1.49 (VCC33), U2.P$2 (3V3), U2.P$4 (3V3), U2.P$70 (3V3), U2.P$72 (3V3), U2.P$74 (3V3), U4.8 (VCC), U5.1 (VBAT), U5.13 (VDDA), U5.17 (VIO_4), U5.31 (VIO_1), U5.32 (VDD_1), U5.50 (VINTA), U5.67 (VIO_3), U5.68 (VDD_3), U6.1 (VIN), U6.3 (EN)
