pythonswirls/Supercluster2/ClusterRaymarcher/src/adc.h

void adcInit()
{
    ADC_InitTypeDef  ADC_InitStructure = {0};
    GPIO_InitTypeDef GPIO_InitStructure = {0};

    RCC_APB2PeriphClockCmd(RCC_APB2Periph_GPIOA, ENABLE);
    RCC_APB2PeriphClockCmd(RCC_APB2Periph_ADC1, ENABLE);
    RCC_ADCCLKConfig(RCC_PCLK2_Div8);

    GPIO_InitStructure.GPIO_Pin = GPIO_Pin_1;
    GPIO_InitStructure.GPIO_Mode = GPIO_Mode_AIN;
    GPIO_Init(GPIOA, &GPIO_InitStructure);

    ADC_DeInit(ADC1);
    ADC_InitStructure.ADC_Mode = ADC_Mode_Independent;
    ADC_InitStructure.ADC_ScanConvMode = DISABLE;
    ADC_InitStructure.ADC_ContinuousConvMode = ENABLE;
    ADC_InitStructure.ADC_ExternalTrigConv = ADC_ExternalTrigInjecConv_None;
    ADC_InitStructure.ADC_DataAlign = ADC_DataAlign_Right;
    ADC_InitStructure.ADC_NbrOfChannel = 1;
    ADC_Init(ADC1, &ADC_InitStructure);
    ADC_Cmd(ADC1, ENABLE);
}

void someothercode()
{
/*RCC_APB2PeriphClockCmd(RCC_APB2Periph_AFIO, ENABLE);
ADC_RegularChannelConfig(ADC1, ADC_Channel_0, 1, ADC_SampleTime_241Cycles);
ADC_SoftwareStartConvCmd(ADC1, ENABLE);
ADC_Cmd(ADC1, ENABLE);
if(ADC_GetFlagStatus(ADC1, ADC_FLAG_EOC))   //sample ready?
        int adc = ADC_GetConversionValue(ADC1) >> 4;*/
}
