pythonswirls/Supercluster2/(commit log)

2025-05-14 max thread count for your system
2025-05-16 vibed webserial example to send receive packets. fixed a few cdc renderer bugs and sending binary counter to webserial
    [main.cpp]
2025-05-21 fixed noneos-sdk missing clock setting to 48MHz internal
    [SystemClockfix.h, main.cpp]
2025-06-03 last changes before bus redesign
    [bus.h, main.cpp]
2025-06-04 new bus.. not worky yet
    [ClientBus.h, ClientBusCH32V003.h, HostBus.h, HostBusCH32V208.h, bus.h, gpio.h, main.cpp, utils.h]
2025-06-05 some bugs fixed. some left
    [ClientBus.h, ClientBusCH32V003.h, HostBus.h, HostBusCH32V208.h, bus.h, main.cpp]
2025-06-06 severe errors fixed. tests for rendering a pixel
    [ClientBus.h, bus.h, main.cpp, utils.h]
2025-06-07 concurrent rendering. communication might bug out, though
    [main.cpp]
2025-06-11 trying to fix all the bugs, without luck. this project kills me
    [ClientBus.h, HostBus.h, HostBusCH32V208.h, bus.h, main.cpp]
2025-06-12 reworking host to only act as realy. tools need to be adjusted now
    [HostBus.h, bus.h, main.cpp]
2025-06-13 fixed hse hsi bug
    [SystemClockfix.h, main.cpp, utils.h]
2025-06-13 new timer methods
2025-06-14 lot of fixes. blink was blocking communication. converted to timeout
    [ClientBusCH32V003.h, main.cpp, timer.h, utils.h]
2025-06-14 LED seems to affect evereything. deactivated on ping
2025-07-05 PCBs added
    [CardSlot.kicad_sch, ch32v003sub.kicad_sch, clusterProgrammer.kicad_pcb, clusterProgrammer.kicad_sch, clusterbase.kicad_pcb, clusterbase.kicad_sch, clustercard.kicad_pcb, clustercard.kicad_sch]
